neilstockbridge/6502-computer/(list of files, drawings)

Other design files:
R1/R1.pcb
stacked/6502.pcb
stacked/FPGA-adapter-2.pcb
stacked/monitor.pcb
stacked/SRAM.pcb
