neilstockbridge/6502-computer/(commit log)

2015-02-10 there is now a page on the Free Run experiment
    [free-run.sch]
2015-02-10 the Free Run schematic now shows the Safe Booting switch
    [free-run.sch]
2015-02-10 there is now a simulator with RAM and a reset vector
    [RAM.c, iMX23.c, iMX23.h, main.c]
2015-02-10 the simulator is now ready for more than one device on the bus
2015-02-10 the simulator can now load a .prg file and has a half-tested serial port device
2015-02-10 there is now a prototypical ROM
    [linker.cfg]
2015-02-10 the ROM is now automatically reloaded and the system reset when the ROM is rebuilt
    [RAM.c, main.c]
2015-02-11 the Free Run schematic is now fixed so that MLB go via pull-up rather than tied high
    [free-run.sch]
2015-02-12 the simulator display is now shown at up to 10 Hz and update_RAM now sleeps for 1 second after the file has been modified prior to loading in order to allow for new contents to be flushed
2015-06-05 there is now a schematic and layout for the R1 SBC
    [R1.pcb, R1.sch]
2015-06-05 there is now a CAD model of an enclosure for R1
    [enclosure.scad]
2015-06-05 old fixes for the ARM-based simulator
    [Queue.c, main.c]
2015-06-08 the simulated bus UART now provides received data
2015-06-08 many changes to the R1 ROM and a ROM uploader
    [linker.cfg]
2015-06-08 the R1 README now explains parts of the board
2015-06-10 the README now refers to the Control UART as the Admin UART
2016-12-16 renamed the ATmega32 symbol
    [R1.sch]
2016-12-16 various changes to R1 before it was abandoned in favour of R2
    [enclosure.scad]
2016-12-16 the PCBs for a modular R2 are now under revision control
    [6502.pcb, 6502.sch, FPGA-adapter-2.pcb, FPGA-adapter-2.sch, SRAM.pcb, SRAM.sch, monitor.pcb, monitor.sch]
